airpaca/Module_Air/README.md

# Module_Air
Dispositif de mesure et d'affichage de la Qualité de l'Air.

Retrouvez [ici](https://github.com/aircarto/ModuleAir_V2.1) la nouvelle mise à jour du code Module Air V2.1 sur le github d'Aircarto.
