airpaca/Module_Air/(threads)

Thread 1 (2019-06-28):

optimisation recuperation json

remyla, 2019-06-28:
optimisations possible au niveau du HTTP: - pouvoir récupérer toutes les valeurs depuis le serveur en une seule requete (ISA, NO2, 03, PM10). ce qui aura l'avantage de faire transiter moins de données, de simplifier le code Arduino et d'être plus rapide.

necessite API revisitée, possibilité implémentation wildcard "*" pour récupérer toutes les valeurs d'un seul coup, en plus de rester compatible avec l'ancien fonctionnement

Thread 2 (2019-06-28):

fona808: localisation GPS

remyla, 2019-06-28:
Pour l'instant la localisation utilise seulement le GSM. Il s'agit d'interroger aussi le GPS. On aura alors plus d'information (altitude etc).

* commencer par GPS
* fail back to GSM

vu avec Mathieu
