airpaca/Module_Air/20181218_AtmoSud_Module_Air/arduino_1_affichage_donnee/arduino_1_affichage_donnee.ino

#include <string.h>

#include <Adafruit_GFX.h> // Ecran
#include <RGBmatrixPanel.h>

#include <Wire.h> // I2C
#include <SPI.h>

#include <NDIRZ16.h> // CO2
#include <SC16IS750.h>

#include <SDS011.h> // PM

#define OE   9
#define LAT 10
#define CLK 11
#define A   A12
#define B   A13
#define C   A14
#define D   A15

/*****************************PM10/2.5***********************************************/
#define TX   14
#define RX   15

SDS011 my_sds;
unsigned char displayTemp[8];
unsigned int Pm25 = 0;
unsigned int Pm10 = 0;
float P25 = 0;// vrai calcul PM2.5
float P10 = 0;// vrai calcul PM10

RGBmatrixPanel matrix(A, B, C, D, CLK, LAT, OE, false, 64);

char Valeur1[5];
char Valeur2[5];
char Valeur3[5];

float Nrouge = 5.1;
float Nvert = 5.1;

//Var I2C
char MtoS[20]; //MasterToSlave
char valo3[5];
char valno2[5];
char CO2[5];
char pm10[5];
char pm25[5];

// Parametres echelle / affichage
int pixel_VL = 48;
int Red;
int Green;
int Blue;

// code couleur de chaque classe de l'echelle
int RGB_0[] = {0, 240, 20}; // classe 0 à 1 (0VL à 0.2VL)
int RGB_1[] = {0, 240, 20}; // classe 1 à 2 (0.2VL à 0.4VL)
int RGB_2[] = {0, 230, 0}; // classe 2 à 3 (0.4VL à 0.6VL)
int RGB_3[] = {255, 255, 0}; // classe 3 à 4 (0.6VL à 0.8VL)
int RGB_4[] = {255, 170, 0}; // classe 4 à 5 (0.8VL à 1VL)
int RGB_5[] = {255, 0, 0}; // classe 5 à 6 (1VL à 2VL)
int RGB_6[] = {128, 0, 0}; // classe 6 (2VL)

//Valeur Limite a modifier
int VLISA = 75; //Horaire
char VISA[5];
char GPST[3];

//CO2
SC16IS750 i2cuart = SC16IS750(SC16IS750_PROTOCOL_I2C, SC16IS750_ADDRESS_BB);
NDIRZ16 mySensor = NDIRZ16(&i2cuart);

void setup()
{
  matrix.begin();
  Wire.begin(10);                // join i2c bus with address #10

  Serial.println("Bonjour");

  Serial.begin(115200);
  i2cuart.begin(9600);

  my_sds.begin(RX, TX);
  Serial3.begin(9600);

  randomSeed(analogRead(0)); // permet un "meilleur" alea

  DemMHZ16();
}

void loop()
{
  matrix.fillRect(0, 0, 64, 32, matrix.Color444(0, 0, 0));

  LogoAtmoSud();
  delay(5000);
  matrix.fillRect(0, 0, 64, 32, matrix.Color444(0, 0, 0));

  RegionSud();
  delay(5000);
  matrix.fillRect(0, 0, 64, 32, matrix.Color444(0, 0, 0));

  LogoModuleAir();
  delay(5000);
  matrix.fillRect(0, 0, 64, 32, matrix.Color444(0, 0, 0));

  AirInterieur();
  delay(5000);
  matrix.fillRect(0, 0, 64, 32, matrix.Color444(0, 0, 0));

  MHZ16DIR();

  SDS011PM();
  delay(7500);
  matrix.fillRect(0, 0, 64, 32, matrix.Color444(0, 0, 0));

  GSMI2C();

  PolExt();
}

//************************************************************************************

void PolExt()
{
  if (strcmp(VISA, "ND") != 0)
  {
    if (strcmp(GPST, "0") == 0)
    {
      AirExtGPS();
      delay(5000);
      matrix.fillRect(0, 0, 64, 32, matrix.Color444(0, 0, 0));
    }
    else if (strcmp(GPST, "1") == 0)
    {
      AirExt();
      delay(5000);
      matrix.fillRect(0, 0, 64, 32, matrix.Color444(0, 0, 0));
    }

    ISA();
  }
}

void ISA()
{
  int isa = 0;
  isa = atoi(VISA);
  matrix.setCursor(2, 0);   // next line
  matrix.setTextSize(1);    // size 1 == 8 pixels high
  matrix.setTextColor(matrix.Color333(7, 7, 7));
  matrix.println("INDICE AIR");
  matrix.setCursor(5, 9);   // next line
  matrix.setTextSize(2);    // size 2 == 16 pixels high
  matrix.setTextColor(matrix.Color888(0, 83, 229));
  matrix.println(isa);

  code_RGB(VLISA, pixel_VL, isa);

  if (isa < 100)
  {
    matrix.fillRect(32, 9, 31, 14, matrix.Color888(Red, Green, Blue));
  } else if (isa >= 100)
  {
    matrix.fillRect(42, 9, 41, 14, matrix.Color888(Red, Green, Blue));
  }

  degrade();

  int posc2 = (isa * 48) / (VLISA);
  Serial.print("Posc2 = ");
  Serial.println(posc2);
  matrix.drawPixel(posc2, 27, matrix.Color444(255, 255, 255));
  matrix.drawLine(posc2 - 1, 26, posc2 + 1, 26, matrix.Color444(255, 255, 255));
  matrix.drawLine(posc2 - 2, 25, posc2 + 2, 25, matrix.Color444(255, 255, 255));
  delay(7500);

  matrix.fillRect(0, 0, 64, 32, matrix.Color444(0, 0, 0));
}

//************************************************************************************

void degrade()
{
  for (int i = 0; i < 65; i++) // degrade de couleur
  {
    code_RGB2(VLISA, pixel_VL, i);
    matrix.drawLine(i, 28, i, 31, matrix.Color888(Red, Green, Blue));
  }
  code_RGB2(VLISA, pixel_VL, pixel_VL);
  matrix.drawLine(pixel_VL, 26, pixel_VL, 27, matrix.Color888(Red, Green, Blue));
}

//**************************************Calcul Ecran*********************************************

//Calcule Degrade de couleur en fonction de la valeur, et de la valeur limite du polluant.
int code_RGB2(int VL_pol, int pixel_VL, int Val_pol)   // VL_pol = VL du polluant à Afficher, pixel_VL = numero du pixel qui marquera la VL sur la Matrice LED, Val_pol = Valeur renvoyée par la sonde ou l'API
{
  int pixel = Val_pol;
  // classe 0 à 1 (0VL à 0.2VL)
  if ( ((pixel_VL * 0) <= pixel) && (pixel <= (pixel_VL * 0.2)) )
  {
    Red = RGB_0[0] + ( (RGB_1[0] - RGB_0[0]) / (pixel_VL * 0.2 - pixel_VL * 0) ) * ( pixel - pixel_VL * 0 ) ; //                   RGB_0[1];
    Green = RGB_0[1] + ( (RGB_1[1] - RGB_0[1]) / (pixel_VL * 0.2 - pixel_VL * 0) ) * ( pixel - pixel_VL * 0 ) ;
    Blue = RGB_0[2] + ( (RGB_1[2] - RGB_0[2]) / (pixel_VL * 0.2 - pixel_VL * 0) ) * ( pixel - pixel_VL * 0 ) ;

    return Red;
    return Green;
    return Blue;

    // classe 1 à 2 (0.2VL à 0.4VL)
  } else if ( ((pixel_VL * 0.2) < pixel) && (pixel <= (pixel_VL * 0.4)) )
  {
    Red = RGB_1[0] + ( (RGB_2[0] - RGB_1[0]) / (pixel_VL * 0.4 - pixel_VL * 0.2) ) * ( pixel - pixel_VL * 0.2 ) ; //                   RGB_0[1];
    Green = RGB_1[1] + ( (RGB_2[1] - RGB_1[1]) / (pixel_VL * 0.4 - pixel_VL * 0.2) ) * ( pixel - pixel_VL * 0.2 ) ;
    Blue = RGB_1[2] + ( (RGB_2[2] - RGB_1[2]) / (pixel_VL * 0.4 - pixel_VL * 0.2) ) * ( pixel - pixel_VL * 0.2 ) ;

    return Red;
    return Green;
    return Blue;

    // classe 2 à 3 (0.4VL à 0.6VL)
  } else if ( ((pixel_VL * 0.4) < pixel) && (pixel <= (pixel_VL * 0.6)) )
  {
    Red = RGB_2[0] + ( (RGB_3[0] - RGB_2[0]) / (pixel_VL * 0.6 - pixel_VL * 0.4) ) * ( pixel - pixel_VL * 0.4 ) ; //                   RGB_0[1];
    Green = RGB_2[1] + ( (RGB_3[1] - RGB_2[1]) / (pixel_VL * 0.6 - pixel_VL * 0.4) ) * ( pixel - pixel_VL * 0.4 ) ;
    Blue = RGB_2[2] + ( (RGB_3[2] - RGB_2[2]) / (pixel_VL * 0.6 - pixel_VL * 0.4) ) * ( pixel - pixel_VL * 0.4 ) ;

    return Red;
    return Green;
    return Blue;

    // classe 3 à 4 (0.6VL à 0.8VL)
  } else if ( ((pixel_VL * 0.6) < pixel) && (pixel <= (pixel_VL * 0.8)) )
  {
    Red = RGB_3[0] + ( (RGB_4[0] - RGB_3[0]) / (pixel_VL * 0.8 - pixel_VL * 0.6) ) * ( pixel - pixel_VL * 0.6 ) ; //                   RGB_0[1];
    Green = RGB_3[1] + ( (RGB_4[1] - RGB_3[1]) / (pixel_VL * 0.8 - pixel_VL * 0.6) ) * ( pixel - pixel_VL * 0.6 ) ;
    Blue = RGB_3[2] + ( (RGB_4[2] - RGB_3[2]) / (pixel_VL * 0.8 - pixel_VL * 0.6) ) * ( pixel - pixel_VL * 0.6 ) ;

    return Red;
    return Green;
    return Blue;

    // classe 4 à 5 (0.8VL à 1VL)
  } else if ( ((pixel_VL * 0.8) < pixel) && (pixel < (pixel_VL * 1)) )
  {
    Red = RGB_4[0] + ( (RGB_5[0] - RGB_4[0]) / (pixel_VL * 1 - pixel_VL * 0.8) ) * ( pixel - pixel_VL * 0.8 ) ; //                   RGB_0[1];
    Green = RGB_4[1] + ( (RGB_5[1] - RGB_4[1]) / (pixel_VL * 1 - pixel_VL * 0.8) ) * ( pixel - pixel_VL * 0.8 ) ;
    Blue = RGB_4[2] + ( (RGB_5[2] - RGB_4[2]) / (pixel_VL * 1 - pixel_VL * 0.8) ) * ( pixel - pixel_VL * 0.8 ) ;

    return Red;
    return Green;
    return Blue;

    // classe 5 à 6 (1VL au delà et l'infini)
  } else if ((pixel_VL * 1) <= pixel)
  {
    Red = RGB_5[0] + ( (RGB_6[0] - RGB_5[0]) / (pixel_VL * 2 - pixel_VL * 1) ) * ( pixel - pixel_VL * 1 ) ; //                   RGB_0[1];
    Green = RGB_5[1] + ( (RGB_6[1] - RGB_5[1]) / (pixel_VL * 2 - pixel_VL * 1) ) * ( pixel - pixel_VL * 1 ) ;
    Blue = RGB_5[2] + ( (RGB_6[2] - RGB_5[2]) / (pixel_VL * 2 - pixel_VL * 1) ) * ( pixel - pixel_VL * 1 ) ;

    return Red;
    return Green;
    return Blue;
  }
} // Fin de la fonction code_RGB


//Calcule Carre de couleur en fonction de la valeur, et de la valeur limite du polluant.
int code_RGB(int VL_pol, int pixel_VL, int Val_pol)   // VL_pol = VL du polluant à Afficher, pixel_VL = numero du pixel qui marquera la VL sur la Matrice LED, Val_pol = Valeur renvoyée par la sonde ou l'API
{
  double pixel = (pixel_VL * Val_pol);
  pixel = pixel / VL_pol ;

  if (pixel > 64)
  {
    pixel = 64;
  }

  // classe 0 à 1 (0VL à 0.2VL)
  if ( ((pixel_VL * 0) <= pixel) && (pixel <= (pixel_VL * 0.2)) )
  {
    Red = RGB_0[0] + ( (RGB_1[0] - RGB_0[0]) / (pixel_VL * 0.2 - pixel_VL * 0) ) * ( pixel - pixel_VL * 0 ) ; //                   RGB_0[1];
    Green = RGB_0[1] + ( (RGB_1[1] - RGB_0[1]) / (pixel_VL * 0.2 - pixel_VL * 0) ) * ( pixel - pixel_VL * 0 ) ;
    Blue = RGB_0[2] + ( (RGB_1[2] - RGB_0[2]) / (pixel_VL * 0.2 - pixel_VL * 0) ) * ( pixel - pixel_VL * 0 ) ;

    return Red;
    return Green;
    return Blue;

    // classe 1 à 2 (0.2VL à 0.4VL)
  } else if ( ((pixel_VL * 0.2) < pixel) && (pixel <= (pixel_VL * 0.4)) )
  {
    Red = RGB_1[0] + ( (RGB_2[0] - RGB_1[0]) / (pixel_VL * 0.4 - pixel_VL * 0.2) ) * ( pixel - pixel_VL * 0.2 ) ; //                   RGB_0[1];
    Green = RGB_1[1] + ( (RGB_2[1] - RGB_1[1]) / (pixel_VL * 0.4 - pixel_VL * 0.2) ) * ( pixel - pixel_VL * 0.2 ) ;
    Blue = RGB_1[2] + ( (RGB_2[2] - RGB_1[2]) / (pixel_VL * 0.4 - pixel_VL * 0.2) ) * ( pixel - pixel_VL * 0.2 ) ;

    return Red;
    return Green;
    return Blue;

    // classe 2 à 3 (0.4VL à 0.6VL)
  } else if ( ((pixel_VL * 0.4) < pixel) && (pixel <= (pixel_VL * 0.6)) )
  {
    Red = RGB_2[0] + ( (RGB_3[0] - RGB_2[0]) / (pixel_VL * 0.6 - pixel_VL * 0.4) ) * ( pixel - pixel_VL * 0.4 ) ; //                   RGB_0[1];
    Green = RGB_2[1] + ( (RGB_3[1] - RGB_2[1]) / (pixel_VL * 0.6 - pixel_VL * 0.4) ) * ( pixel - pixel_VL * 0.4 ) ;
    Blue = RGB_2[2] + ( (RGB_3[2] - RGB_2[2]) / (pixel_VL * 0.6 - pixel_VL * 0.4) ) * ( pixel - pixel_VL * 0.4 ) ;

    return Red;
    return Green;
    return Blue;

    // classe 3 à 4 (0.6VL à 0.8VL)
  } else if ( ((pixel_VL * 0.6) < pixel) && (pixel <= (pixel_VL * 0.8)) )
  {
    Red = RGB_3[0] + ( (RGB_4[0] - RGB_3[0]) / (pixel_VL * 0.8 - pixel_VL * 0.6) ) * ( pixel - pixel_VL * 0.6 ) ; //                   RGB_0[1];
    Green = RGB_3[1] + ( (RGB_4[1] - RGB_3[1]) / (pixel_VL * 0.8 - pixel_VL * 0.6) ) * ( pixel - pixel_VL * 0.6 ) ;
    Blue = RGB_3[2] + ( (RGB_4[2] - RGB_3[2]) / (pixel_VL * 0.8 - pixel_VL * 0.6) ) * ( pixel - pixel_VL * 0.6 ) ;

    return Red;
    return Green;
    return Blue;

    // classe 4 à 5 (0.8VL à 1VL)
  } else if ( ((pixel_VL * 0.8) < pixel) && (pixel < (pixel_VL * 1)) )
  {
    Red = RGB_4[0] + ( (RGB_5[0] - RGB_4[0]) / (pixel_VL * 1 - pixel_VL * 0.8) ) * ( pixel - pixel_VL * 0.8 ) ; //                   RGB_0[1];
    Green = RGB_4[1] + ( (RGB_5[1] - RGB_4[1]) / (pixel_VL * 1 - pixel_VL * 0.8) ) * ( pixel - pixel_VL * 0.8 ) ;
    Blue = RGB_4[2] + ( (RGB_5[2] - RGB_4[2]) / (pixel_VL * 1 - pixel_VL * 0.8) ) * ( pixel - pixel_VL * 0.8 ) ;

    return Red;
    return Green;
    return Blue;

    // classe 5 à 6 (1VL au delà et l'infini)
  } else if ((pixel_VL * 1) <= pixel)
  {
    Red = RGB_5[0] + ( (RGB_6[0] - RGB_5[0]) / (pixel_VL * 2 - pixel_VL * 1) ) * ( pixel - pixel_VL * 1 ) ; //                   RGB_0[1];
    Green = RGB_5[1] + ( (RGB_6[1] - RGB_5[1]) / (pixel_VL * 2 - pixel_VL * 1) ) * ( pixel - pixel_VL * 1 ) ;
    Blue = RGB_5[2] + ( (RGB_6[2] - RGB_5[2]) / (pixel_VL * 2 - pixel_VL * 1) ) * ( pixel - pixel_VL * 1 ) ;

    return Red;
    return Green;
    return Blue;
  }
} // Fin de la fonction code_RGB

void GSMI2C()
{
  Wire.requestFrom(8, 14);    // request 14 bytes from slave device #8
  while (Wire.available())
  { // slave may send less than requested
    char c[20];
    int x = 0;
    for (int y = 0; y < 14 ; y++)
    {
      c[x] = Wire.read(); // receive a byte as character
      x++;
    }
    c[x] = '\0';
    Serial.print("C: ");
    Serial.println(c);         // print the character
    strcpy(Valeur3, c);
    delay(1000);

    //Coupe à chaque "," le contenu de C
    strtok(c, ",");

    //Attribut à Val1,2,3 les valeurs recuperees a chaques decoupage
    strcpy(VISA, strtok(NULL, ","));
    Serial.print("Val1: ");
    Serial.println(VISA);
    strcpy(GPST, strtok(NULL, ","));
    Serial.print("GPS: ");
    Serial.println(GPST);
  }
  delay(500);
}

/********************************************SondeCO2********************************************/

void DemMHZ16() // Commande du Setup pour vérifier si la sonde répond.
{
  if (i2cuart.ping())
  {
    Serial.println("SC16IS750 found.");
    Serial.println("Wait 10 seconds for sensor initialization...");

    power(1);
    //Wait for the NDIR sensor to initialize.
    delay(10000);
  } else
  {
    Serial.println("SC16IS750 not found.");
    while (1);
  }
}

void power (uint8_t state) // Commande d'allumage de la Sonde.
{
  i2cuart.pinMode(0, INPUT);      //set up for the power control pin

  if (state) {
    i2cuart.pinMode(0, INPUT);  //turn on the power of MH-Z16
  } else {
    i2cuart.pinMode(0, OUTPUT);
    i2cuart.digitalWrite(0, 0); //turn off the power of MH-Z16
  }
}

void MHZ16DIR() // Lecture + message de prévention du CO2
{
  if (mySensor.measure())
  { // mesure CO2
    matrix.fillRect(0, 8, 64, 24, matrix.Color444(0, 0, 0));
    //CO2
    matrix.fillRect(0, 0, 64, 32, matrix.Color444(0, 0, 0));
    matrix.setCursor(2, 0);   // next line
    matrix.setTextSize(1);    // size 1 == 8 pixels high
    matrix.setTextColor(matrix.Color888(0, 82, 228));
    matrix.println(" CO ppm");

    //2 de CO2 en indice
    matrix.drawLine(20, 3, 21, 3, matrix.Color888(0, 82, 228));
    matrix.drawLine(22, 4, 22, 4, matrix.Color888(0, 82, 228));
    matrix.drawLine(21, 5, 21, 5, matrix.Color888(0, 82, 228));
    matrix.drawLine(20, 6, 20, 6, matrix.Color888(0, 82, 228));
    matrix.drawLine(20, 7, 22, 7, matrix.Color888(0, 82, 228));
    
    //Petite maison
    matrix.drawLine(55, 4, 56, 4, matrix.Color333(7, 7, 7));
    matrix.drawLine(62, 4, 63, 4, matrix.Color333(7, 7, 7));
    matrix.drawLine(59, 0, 59, 0, matrix.Color333(7, 7, 7));
    matrix.drawLine(58, 1, 58, 1, matrix.Color333(7, 7, 7));
    matrix.drawLine(60, 1, 60, 1, matrix.Color333(7, 7, 7));
    matrix.drawLine(57, 2, 57, 2, matrix.Color333(7, 7, 7));
    matrix.drawLine(61, 2, 61, 2, matrix.Color333(7, 7, 7));
    matrix.drawLine(56, 3, 56, 3, matrix.Color333(7, 7, 7));
    matrix.drawLine(62, 3, 62, 3, matrix.Color333(7, 7, 7));
    matrix.drawLine(56, 5, 56, 5, matrix.Color333(7, 7, 7));
    matrix.drawLine(62, 5, 62, 5, matrix.Color333(7, 7, 7));
    matrix.drawLine(56, 6, 56, 6, matrix.Color333(7, 7, 7));
    matrix.drawLine(62, 6, 62, 6, matrix.Color333(7, 7, 7));
    matrix.drawLine(56, 7, 62, 7, matrix.Color333(7, 7, 7));

    matrix.setCursor(5, 9);   // next line
    matrix.setTextSize(2);    // size 2 == 16 pixels high

    Serial.print("CO2 :");
    Serial.println(mySensor.ppm);

    if (mySensor.ppm <= 1000)
    { // CO2 niv bon
      matrix.fillRect(47, 9, 17, 14, matrix.Color444(0, 15, 0));
      matrix.setCursor(21, 25);   // next line
      matrix.setTextSize(1);    // size 1 == 8 pixels high
      matrix.setTextColor(matrix.Color333(0, 7, 0));
      matrix.println("BIEN");
      matrix.setCursor(6, 9);
      matrix.setTextSize(2);
      matrix.setTextColor(matrix.Color333(7, 7, 7));
      matrix.println(mySensor.ppm);
    } // fin CO2 niv bon

    if (mySensor.ppm > 1000 && mySensor.ppm <= 1700)
    { // CO2 niv moyen
      matrix.fillRect(47, 9, 17, 14, matrix.Color444(15, 15, 0));
      matrix.setCursor(7, 25);   // next line
      matrix.setTextSize(1);    // size 1 == 8 pixels high
      matrix.setTextColor(matrix.Color333(7, 7, 0));
      matrix.println("AERER SVP");
      matrix.setTextColor(matrix.Color333(7, 7, 7));
      matrix.setCursor(0, 9);
      matrix.setTextSize(2);
      matrix.println(mySensor.ppm);
    } // fin CO2 niv moyen

    if (mySensor.ppm > 1700)
    { // CO2 niv mauvais
      matrix.fillRect(47, 9, 17, 14, matrix.Color444(15, 0, 0));
      matrix.setCursor(3, 25);   // next line
      matrix.setTextSize(1);    // size 1 == 8 pixels high
      matrix.setTextColor(matrix.Color333(7, 0, 0));
      matrix.println("AERER VITE");
      matrix.setTextColor(matrix.Color333(7, 7, 7));
      matrix.setCursor(0, 9);
      matrix.setTextSize(2);
      matrix.println(mySensor.ppm);
    } // fin CO2 niv mauvais
    snprintf(CO2, sizeof CO2, "%lu", (unsigned long)mySensor.ppm);
    delay(7500);
    matrix.fillRect(0, 0, 64, 32, matrix.Color444(0, 0, 0));
  } // fin mesure CO2
}

/********************************************SondePM********************************************/

// Lecture PM
void SDS011PM()
{
  uint8_t mData = 0;
  uint8_t i = 0;
  uint8_t mPkt[10] = {0};
  uint8_t mCheck = 0;
  while (Serial3.available() > 0)
  {
    mData = Serial3.read();     delay(2);//wait until packet is received

    if (mData == 0xAA) //head1 ok
    {
      mPkt[0] =  mData;
      mData = Serial3.read();

      if (mData == 0xc0) //head2 ok
      {
        mPkt[1] =  mData;
        mCheck = 0;
        for (i = 0; i < 6; i++) //data recv and crc calc
        {
          mPkt[i + 2] = Serial3.read();
          delay(2);
          mCheck += mPkt[i + 2];
        }
        mPkt[8] = Serial3.read();
        delay(1);
        mPkt[9] = Serial3.read();
        if (mCheck == mPkt[8]) //crc ok
        {
          Serial3.flush();

          Pm25 = (uint16_t)mPkt[2] | (uint16_t)(mPkt[3] << 8);
          Pm10 = (uint16_t)mPkt[4] | (uint16_t)(mPkt[5] << 8);
          if (Pm25 > 9999)
            Pm25 = 9999;
          if (Pm10 > 9999)
            Pm10 = 9999;

          P25 = (float(Pm25) / 10);
          P10 = (float(Pm10) / 10);

          matrix.fillRect(0, 0, 64, 32, matrix.Color444(0, 0, 0));
          matrix.setCursor(0, 0);   // next line
          matrix.setTextSize(1);    // size 1 == 8 pixels high
          matrix.setTextColor(matrix.Color888(0, 82, 228));
          matrix.println("PM10");

          matrix.drawLine(51, 0, 52, 0, matrix.Color888(0, 82, 228));
          matrix.drawLine(59, 0, 59, 0, matrix.Color333(7, 7, 7));
          matrix.drawLine(43, 1, 43, 1, matrix.Color888(0, 82, 228));
          matrix.drawLine(53, 1, 53, 1, matrix.Color888(0, 82, 228));
          matrix.drawLine(58, 1, 58, 1, matrix.Color333(7, 7, 7));
          matrix.drawLine(60, 1, 60, 1, matrix.Color333(7, 7, 7));
          matrix.drawLine(28, 2, 28, 2, matrix.Color888(0, 82, 228));
          matrix.drawLine(32, 2, 32, 2, matrix.Color888(0, 82, 228));
          matrix.drawLine(35, 2, 37, 2, matrix.Color888(0, 82, 228));
          matrix.drawLine(42, 2, 42, 2, matrix.Color888(0, 82, 228));
          matrix.drawLine(52, 2, 53, 2, matrix.Color888(0, 82, 228));
          matrix.drawLine(57, 2, 57, 2, matrix.Color333(7, 7, 7));
          matrix.drawLine(61, 2, 61, 2, matrix.Color333(7, 7, 7));
          matrix.drawLine(28, 3, 28, 3, matrix.Color888(0, 82, 228));
          matrix.drawLine(32, 3, 32, 3, matrix.Color888(0, 82, 228));
          matrix.drawLine(34, 3, 34, 3, matrix.Color888(0, 82, 228));
          matrix.drawLine(37, 3, 38, 3, matrix.Color888(0, 82, 228));
          matrix.drawLine(42, 3, 42, 3, matrix.Color888(0, 82, 228));
          matrix.drawLine(45, 3, 46, 3, matrix.Color888(0, 82, 228));
          matrix.drawLine(48, 3, 48, 3, matrix.Color888(0, 82, 228));
          matrix.drawLine(53, 3, 53, 3, matrix.Color888(0, 82, 228));
          matrix.drawLine(56, 3, 56, 3, matrix.Color333(7, 7, 7));
          matrix.drawLine(62, 3, 62, 3, matrix.Color333(7, 7, 7));
          matrix.drawLine(28, 4, 28, 4, matrix.Color888(0, 82, 228));
          matrix.drawLine(32, 4, 32, 4, matrix.Color888(0, 82, 228));
          matrix.drawLine(34, 4, 34, 4, matrix.Color888(0, 82, 228));
          matrix.drawLine(37, 4, 38, 4, matrix.Color888(0, 82, 228));
          matrix.drawLine(41, 4, 41, 4, matrix.Color888(0, 82, 228));
          matrix.drawLine(45, 4, 45, 4, matrix.Color888(0, 82, 228));
          matrix.drawLine(47, 4, 47, 4, matrix.Color888(0, 82, 228));
          matrix.drawLine(49, 4, 49, 4, matrix.Color888(0, 82, 228));
          matrix.drawLine(51, 4, 52, 4, matrix.Color888(0, 82, 228));
          matrix.drawLine(55, 4, 56, 4, matrix.Color333(7, 7, 7));
          matrix.drawLine(62, 4, 63, 4, matrix.Color333(7, 7, 7));
          matrix.drawLine(28, 5, 28, 5, matrix.Color888(0, 82, 228));
          matrix.drawLine(31, 5, 32, 5, matrix.Color888(0, 82, 228));
          matrix.drawLine(35, 5, 36, 5, matrix.Color888(0, 82, 228));
          matrix.drawLine(38, 5, 38, 5, matrix.Color888(0, 82, 228));
          matrix.drawLine(41, 5, 41, 5, matrix.Color888(0, 82, 228));
          matrix.drawLine(45, 5, 45, 5, matrix.Color888(0, 82, 228));
          matrix.drawLine(47, 5, 47, 5, matrix.Color888(0, 82, 228));
          matrix.drawLine(49, 5, 49, 5, matrix.Color888(0, 82, 228));
          matrix.drawLine(56, 5, 56, 5, matrix.Color333(7, 7, 7));
          matrix.drawLine(62, 5, 62, 5, matrix.Color333(7, 7, 7));
          matrix.drawLine(28, 6, 30, 6, matrix.Color888(0, 82, 228));
          matrix.drawLine(32, 6, 32, 6, matrix.Color888(0, 82, 228));
          matrix.drawLine(38, 6, 38, 6, matrix.Color888(0, 82, 228));
          matrix.drawLine(40, 6, 40, 6, matrix.Color888(0, 82, 228));
          matrix.drawLine(45, 6, 45, 6, matrix.Color888(0, 82, 228));
          matrix.drawLine(47, 6, 47, 6, matrix.Color888(0, 82, 228));
          matrix.drawLine(49, 6, 49, 6, matrix.Color888(0, 82, 228));
          matrix.drawLine(56, 6, 56, 6, matrix.Color333(7, 7, 7));
          matrix.drawLine(62, 6, 62, 6, matrix.Color333(7, 7, 7));
          matrix.drawLine(28, 7, 28, 7, matrix.Color888(0, 82, 228));
          matrix.drawLine(35, 7, 37, 7, matrix.Color888(0, 82, 228));
          matrix.drawLine(45, 7, 45, 7, matrix.Color888(0, 82, 228));
          matrix.drawLine(47, 7, 47, 7, matrix.Color888(0, 82, 228));
          matrix.drawLine(49, 7, 49, 7, matrix.Color888(0, 82, 228));
          matrix.drawLine(56, 7, 62, 7, matrix.Color333(7, 7, 7));

          matrix.setCursor(5, 9);   // next line
          matrix.setTextSize(2);    // size 2 == 16 pixels high

          if (P10 <= 15) { // PM10 niv IDEAL
            matrix.fillRect(47, 9, 17, 14, matrix.Color444(0, 15, 0));

            matrix.setCursor(18, 25);   // next line
            matrix.setTextSize(1);    // size 1 == 8 pixels high
            matrix.setTextColor(matrix.Color333(0, 7, 0));
            matrix.println("IDEAL");

            if (P10 >= 5 && P10 < 10)
            {
              matrix.setCursor(6, 9);//placement du curseur differents >5 et <10
              matrix.setTextSize(2);
              matrix.setTextColor(matrix.Color333(7, 7, 7));
              matrix.println(P10, 1);
            }
            else if (P10 < 5)
            {
              matrix.setCursor(0, 9);
              matrix.setTextSize(2);
              matrix.setTextColor(matrix.Color333(7, 7, 7));
              matrix.println("< 5"); // affichage borné inf à 5
            }
            else
            {
              matrix.setCursor(0, 9);
              matrix.setTextSize(2);
              matrix.setTextColor(matrix.Color333(7, 7, 7));
              matrix.println(P10, 1);
            }
          } // fin PM10 niv bon

          if (P10 > 75)
          { // CO2 niv mauvais
            //matrix.setTextColor(matrix.Color444(15, 0, 0));
            matrix.fillRect(47, 9, 17, 14, matrix.Color444(15, 0, 0));
            matrix.setCursor(3, 25);   // next line
            matrix.setTextSize(1);    // size 1 == 8 pixels high
            matrix.setTextColor(matrix.Color333(7, 0, 0));
            matrix.println("MAUVAIS");
            matrix.setTextColor(matrix.Color333(7, 7, 7));
            matrix.setCursor(0, 9);
            matrix.setTextSize(2);
            if (P10 > 99)
            {
              matrix.println(P10, 0);
            }
            else
            {
              matrix.println(P10, 1);
            }
          } // fin PM10 niv mauvais

          if (P10 > 15 && P10 <= 30)
          { // CO2 niv BON
            // matrix.setTextColor(matrix.Color444(15, 15, 0));
            matrix.fillRect(47, 9, 17, 14, matrix.Color444(15, 15, 0));
            matrix.setCursor(22, 25);   // next line
            matrix.setTextSize(1);    // size 1 == 8 pixels high
            matrix.setTextColor(matrix.Color333(7, 7, 0));
            matrix.println("BON");
            matrix.setTextColor(matrix.Color333(7, 7, 7));
            matrix.setCursor(0, 9);
            matrix.setTextSize(2);
            matrix.println(P10, 1);
          }

          if (P10 > 30 && P10 <= 75)
          { // CO2 niv moyen
            // matrix.setTextColor(matrix.Color444(15, 15, 0));
            matrix.fillRect(47, 9, 17, 14, matrix.Color444(15, 15, 0));
            matrix.setCursor(15, 25);   // next line
            matrix.setTextSize(1);    // size 1 == 8 pixels high
            matrix.setTextColor(matrix.Color333(7, 7, 0));
            matrix.println("MOYEN");
            matrix.setTextColor(matrix.Color333(7, 7, 7));
            matrix.setCursor(0, 9);
            matrix.setTextSize(2);
            matrix.println(P10, 1);
          }

          delay(7500);
          matrix.fillRect(0, 0, 64, 32, matrix.Color444(0, 0, 0));

          matrix.setCursor(0, 0);   // next line
          matrix.setTextSize(1);    // size 1 == 8 pixels high
          matrix.setTextColor(matrix.Color888(0, 82, 228));
          matrix.println("PM2");
          matrix.setCursor(20, 0);
          matrix.drawPixel(18, 6, matrix.Color888(0, 82, 228));
          matrix.println("5");

          matrix.drawLine(51, 0, 52, 0, matrix.Color888(0, 82, 228));
          matrix.drawLine(59, 0, 59, 0, matrix.Color333(7, 7, 7));
          matrix.drawLine(43, 1, 43, 1, matrix.Color888(0, 82, 228));
          matrix.drawLine(53, 1, 53, 1, matrix.Color888(0, 82, 228));
          matrix.drawLine(58, 1, 58, 1, matrix.Color333(7, 7, 7));
          matrix.drawLine(60, 1, 60, 1, matrix.Color333(7, 7, 7));
          matrix.drawLine(28, 2, 28, 2, matrix.Color888(0, 82, 228));
          matrix.drawLine(32, 2, 32, 2, matrix.Color888(0, 82, 228));
          matrix.drawLine(35, 2, 37, 2, matrix.Color888(0, 82, 228));
          matrix.drawLine(42, 2, 42, 2, matrix.Color888(0, 82, 228));
          matrix.drawLine(52, 2, 53, 2, matrix.Color888(0, 82, 228));
          matrix.drawLine(57, 2, 57, 2, matrix.Color333(7, 7, 7));
          matrix.drawLine(61, 2, 61, 2, matrix.Color333(7, 7, 7));
          matrix.drawLine(28, 3, 28, 3, matrix.Color888(0, 82, 228));
          matrix.drawLine(32, 3, 32, 3, matrix.Color888(0, 82, 228));
          matrix.drawLine(34, 3, 34, 3, matrix.Color888(0, 82, 228));
          matrix.drawLine(37, 3, 38, 3, matrix.Color888(0, 82, 228));
          matrix.drawLine(42, 3, 42, 3, matrix.Color888(0, 82, 228));
          matrix.drawLine(45, 3, 46, 3, matrix.Color888(0, 82, 228));
          matrix.drawLine(48, 3, 48, 3, matrix.Color888(0, 82, 228));
          matrix.drawLine(53, 3, 53, 3, matrix.Color888(0, 82, 228));
          matrix.drawLine(56, 3, 56, 3, matrix.Color333(7, 7, 7));
          matrix.drawLine(62, 3, 62, 3, matrix.Color333(7, 7, 7));
          matrix.drawLine(28, 4, 28, 4, matrix.Color888(0, 82, 228));
          matrix.drawLine(32, 4, 32, 4, matrix.Color888(0, 82, 228));
          matrix.drawLine(34, 4, 34, 4, matrix.Color888(0, 82, 228));
          matrix.drawLine(37, 4, 38, 4, matrix.Color888(0, 82, 228));
          matrix.drawLine(41, 4, 41, 4, matrix.Color888(0, 82, 228));
          matrix.drawLine(45, 4, 45, 4, matrix.Color888(0, 82, 228));
          matrix.drawLine(47, 4, 47, 4, matrix.Color888(0, 82, 228));
          matrix.drawLine(49, 4, 49, 4, matrix.Color888(0, 82, 228));
          matrix.drawLine(51, 4, 52, 4, matrix.Color888(0, 82, 228));
          matrix.drawLine(55, 4, 56, 4, matrix.Color333(7, 7, 7));
          matrix.drawLine(62, 4, 63, 4, matrix.Color333(7, 7, 7));
          matrix.drawLine(28, 5, 28, 5, matrix.Color888(0, 82, 228));
          matrix.drawLine(31, 5, 32, 5, matrix.Color888(0, 82, 228));
          matrix.drawLine(35, 5, 36, 5, matrix.Color888(0, 82, 228));
          matrix.drawLine(38, 5, 38, 5, matrix.Color888(0, 82, 228));
          matrix.drawLine(41, 5, 41, 5, matrix.Color888(0, 82, 228));
          matrix.drawLine(45, 5, 45, 5, matrix.Color888(0, 82, 228));
          matrix.drawLine(47, 5, 47, 5, matrix.Color888(0, 82, 228));
          matrix.drawLine(49, 5, 49, 5, matrix.Color888(0, 82, 228));
          matrix.drawLine(56, 5, 56, 5, matrix.Color333(7, 7, 7));
          matrix.drawLine(62, 5, 62, 5, matrix.Color333(7, 7, 7));
          matrix.drawLine(28, 6, 30, 6, matrix.Color888(0, 82, 228));
          matrix.drawLine(32, 6, 32, 6, matrix.Color888(0, 82, 228));
          matrix.drawLine(38, 6, 38, 6, matrix.Color888(0, 82, 228));
          matrix.drawLine(40, 6, 40, 6, matrix.Color888(0, 82, 228));
          matrix.drawLine(45, 6, 45, 6, matrix.Color888(0, 82, 228));
          matrix.drawLine(47, 6, 47, 6, matrix.Color888(0, 82, 228));
          matrix.drawLine(49, 6, 49, 6, matrix.Color888(0, 82, 228));
          matrix.drawLine(56, 6, 56, 6, matrix.Color333(7, 7, 7));
          matrix.drawLine(62, 6, 62, 6, matrix.Color333(7, 7, 7));
          matrix.drawLine(28, 7, 28, 7, matrix.Color888(0, 82, 228));
          matrix.drawLine(35, 7, 37, 7, matrix.Color888(0, 82, 228));
          matrix.drawLine(45, 7, 45, 7, matrix.Color888(0, 82, 228));
          matrix.drawLine(47, 7, 47, 7, matrix.Color888(0, 82, 228));
          matrix.drawLine(49, 7, 49, 7, matrix.Color888(0, 82, 228));
          matrix.drawLine(56, 7, 62, 7, matrix.Color333(7, 7, 7));

          if (P25 < 10) { // PM2,5 niv IDEAL

            matrix.fillRect(47, 9, 17, 14, matrix.Color444(0, 15, 0));

            matrix.setCursor(18, 25);   // next line
            matrix.setTextSize(1);    // size 1 == 8 pixels high
            matrix.setTextColor(matrix.Color333(0, 7, 0));
            matrix.println("IDEAL");

            if (P25 < 3)
            {
              matrix.setCursor(0, 9);
              matrix.setTextSize(2);
              matrix.setTextColor(matrix.Color333(7, 7, 7));
              matrix.println("< 3"); // affichage borné inf à 3
            }
            else
            {
              matrix.setCursor(6, 9);
              matrix.setTextSize(2);
              matrix.setTextColor(matrix.Color333(7, 7, 7));
              matrix.println(P25, 1);
            }
          } // fin PM2,5 niv bon

          if (P25 > 50) { // PM2,5 niv mauvais
            //matrix.setTextColor(matrix.Color444(15, 0, 0));
            matrix.fillRect(47, 9, 17, 14, matrix.Color444(15, 0, 0));
            matrix.setCursor(3, 25);   // next line
            matrix.setTextSize(1);    // size 1 == 8 pixels high
            matrix.setTextColor(matrix.Color333(7, 0, 0));
            matrix.println("MAUVAIS");
            matrix.setTextColor(matrix.Color333(7, 7, 7));
            matrix.setCursor(0, 9);
            matrix.setTextSize(2);
            if (P25 > 99) {
              matrix.println(P25, 0);
            }
            else {
              matrix.println(P25, 1);
            }
          } // fin PM2,5 niv mauvais

          if (P25 >= 10 && P25 <= 20) { // PM2,5 niv BON
            // matrix.setTextColor(matrix.Color444(15, 15, 0));
            matrix.fillRect(47, 9, 17, 14, matrix.Color444(15, 15, 0));
            matrix.setCursor(22, 25);   // next line
            matrix.setTextSize(1);    // size 1 == 8 pixels high
            matrix.setTextColor(matrix.Color333(7, 7, 0));
            matrix.println("BON");
            matrix.setTextColor(matrix.Color333(7, 7, 7));
            matrix.setCursor(0, 9);
            matrix.setTextSize(2);
            matrix.println(P25, 1);
          }

          if (P25 > 20 && P25 <= 50) { // PM2,5 niv moyen
            // matrix.setTextColor(matrix.Color444(15, 15, 0));
            matrix.fillRect(47, 9, 17, 14, matrix.Color444(15, 15, 0));
            matrix.setCursor(15, 25);   // next line
            matrix.setTextSize(1);    // size 1 == 8 pixels high
            matrix.setTextColor(matrix.Color333(7, 7, 0));
            matrix.println("MOYEN");
            matrix.setTextColor(matrix.Color333(7, 7, 7));
            matrix.setCursor(0, 9);
            matrix.setTextSize(2);
            matrix.println(P25, 1);
          }
          return;
        }
      }
    }
  }
  if (Serial3.available() == 0)
  {
    matrix.setCursor(32, 15);   // next line
    matrix.setTextSize(1);    // size 1 == 8 pixels high
    matrix.setTextColor(matrix.Color333(7, 0, 0));
    matrix.println("Init");
    delay(5000);
    matrix.fillRect(0, 0, 64, 32, matrix.Color444(0, 0, 0));
  }
}

/********************************************ECRAN********************************************/

void LogoModuleAir()
{
  matrix.drawLine(1, 0, 7, 0, matrix.Color888(255, 255, 255));
  matrix.drawLine(0, 1, 6, 1, matrix.Color888(255, 255, 255));
  matrix.drawLine(11, 1, 12, 1, matrix.Color888(255, 255, 255));
  matrix.drawLine(4, 2, 6, 2, matrix.Color888(255, 255, 255));
  matrix.drawLine(10, 2, 13, 2, matrix.Color888(255, 255, 255));
  matrix.drawLine(3, 3, 6, 3, matrix.Color888(255, 255, 255));
  matrix.drawLine(9, 3, 13, 3, matrix.Color888(255, 255, 255));
  matrix.drawLine(17, 3, 18, 3, matrix.Color888(255, 255, 255));
  matrix.drawLine(3, 4, 6, 4, matrix.Color888(255, 255, 255));
  matrix.drawLine(8, 4, 12, 4, matrix.Color888(255, 255, 255));
  matrix.drawLine(16, 4, 19, 4, matrix.Color888(255, 255, 255));
  matrix.drawLine(3, 5, 5, 5, matrix.Color888(255, 255, 255));
  matrix.drawLine(8, 5, 12, 5, matrix.Color888(255, 255, 255));
  matrix.drawLine(15, 5, 19, 5, matrix.Color888(255, 255, 255));
  matrix.drawLine(37, 5, 38, 5, matrix.Color888(255, 255, 255));
  matrix.drawLine(52, 5, 53, 5, matrix.Color888(255, 255, 255));
  matrix.drawLine(2, 6, 5, 6, matrix.Color888(255, 255, 255));
  matrix.drawLine(7, 6, 11, 6, matrix.Color888(255, 255, 255));
  matrix.drawLine(14, 6, 19, 6, matrix.Color888(255, 255, 255));
  matrix.drawLine(36, 6, 38, 6, matrix.Color888(255, 255, 255));
  matrix.drawLine(51, 6, 53, 6, matrix.Color888(255, 255, 255));
  matrix.drawLine(2, 7, 11, 7, matrix.Color888(255, 255, 255));
  matrix.drawLine(13, 7, 18, 7, matrix.Color888(255, 255, 255));
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
  matrix.drawLine(63, 23, 63, 23, matrix.Color888(7, 32, 220));
  matrix.drawLine(3, 24, 3, 24, matrix.Color888(180, 180, 180));
  matrix.drawLine(5, 24, 5, 24, matrix.Color888(180, 180, 180));
  matrix.drawLine(8, 24, 8, 24, matrix.Color888(180, 180, 180));
  matrix.drawLine(11, 24, 11, 24, matrix.Color888(180, 180, 180));
  matrix.drawLine(14, 24, 16, 24, matrix.Color888(180, 180, 180));
  matrix.drawLine(18, 24, 18, 24, matrix.Color888(180, 180, 180));
  matrix.drawLine(21, 24, 21, 24, matrix.Color888(180, 180, 180));
  matrix.drawLine(24, 24, 26, 24, matrix.Color888(180, 180, 180));
  matrix.drawLine(28, 24, 29, 24, matrix.Color888(180, 180, 180));
  matrix.drawLine(31, 24, 31, 24, matrix.Color888(180, 180, 180));
  matrix.drawLine(33, 24, 33, 24, matrix.Color888(180, 180, 180));
  matrix.drawLine(40, 24, 47, 24, matrix.Color888(180, 180, 180));
  matrix.drawLine(49, 24, 50, 24, matrix.Color888(180, 180, 180));
  matrix.drawLine(52, 24, 54, 24, matrix.Color888(180, 180, 180));
  matrix.drawLine(58, 24, 59, 24, matrix.Color888(180, 180, 180));
  matrix.drawLine(63, 24, 63, 24, matrix.Color888(1, 3, 24));
  matrix.drawLine(40, 25, 47, 25, matrix.Color888(180, 180, 180));
  matrix.drawLine(49, 25, 50, 25, matrix.Color888(180, 180, 180));
  matrix.drawLine(52, 25, 54, 25, matrix.Color888(180, 180, 180));
  matrix.drawLine(56, 25, 56, 25, matrix.Color888(180, 180, 180));
  matrix.drawLine(58, 25, 59, 25, matrix.Color888(180, 180, 180));
  matrix.drawLine(40, 26, 47, 26, matrix.Color888(180, 180, 180));
  matrix.drawLine(49, 26, 50, 26, matrix.Color888(180, 180, 180));
  matrix.drawLine(52, 26, 54, 26, matrix.Color888(180, 180, 180));
  matrix.drawLine(56, 26, 56, 26, matrix.Color888(180, 180, 180));
  matrix.drawLine(58, 26, 59, 26, matrix.Color888(180, 180, 180));
}
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
